SourceK78/psp-1000-consolizer/assets/wiring_org.JPG

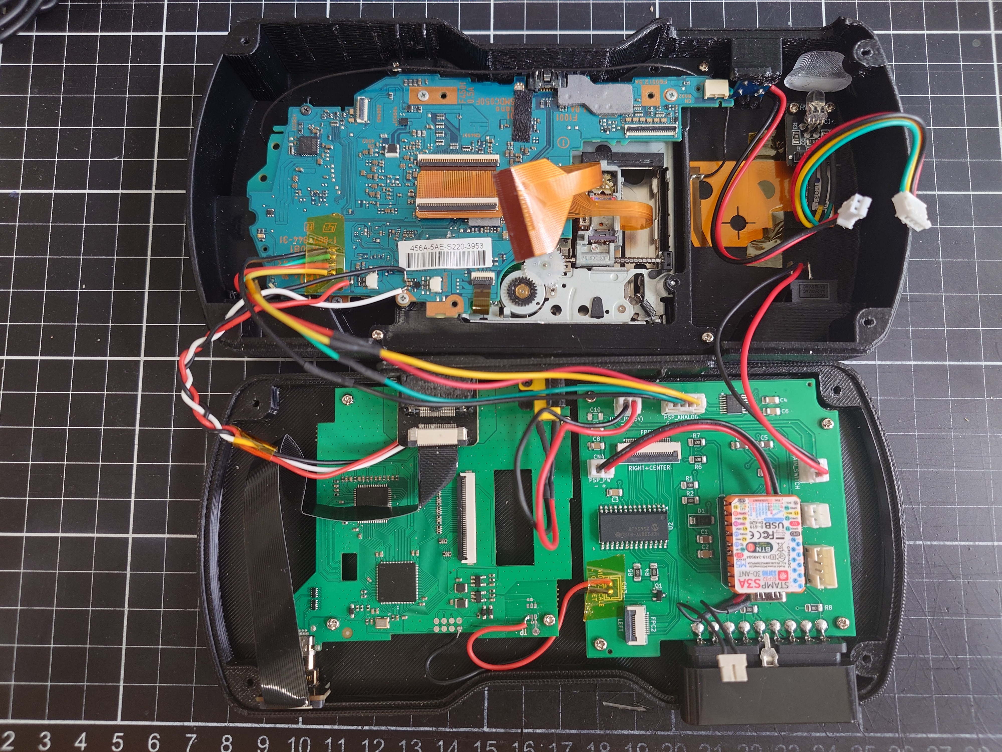
assets/wiring_org.JPG
