SourceK78/psp-1000-consolizer/(commit log)

2026-06-24 fix BOM
    [bom.csv, positions.csv]
2026-06-30 Add wiring description
2026-07-04 Fix Pop'n Music controller Mode
    [psp-1000-control.ino]
2026-07-12 Minimize latency and Fix deadzone for right stick mode2
    [psp-1000-control.ino]
