SourceK78/psp-1000-consolizer/(notices)

Notices in the files:
psp-1000-control/psp-1000-control.ino:
Copyright (C) 2019-2020 by SukkoPera <software@sukkology.net>
modify it under the terms of the GNU General Public License as published by
the Free Software Foundation, either version 3 of the License, or
(at your option) any later version.
